mtab05/pls-simulator/README.md

# pls-simulator
Video description of project - https://www.youtube.com/watch?v=LKZQRzaUKww

Project report - https://github.com/mtab05/pls-simulator/blob/main/Final_Report-Haptic_Feedback_Training_for_Pediatric_Laparoscopic_Surgery_Simulators-Group20.pdf
