mtab05/pls-simulator/(commit log)

2021-11-17 Basic sketch to test multiple LRA motors using multiple PWM pins
2021-11-19 IMU sketch commit #1
    This version uses I2C to link the Arduino to 2 IMUs, however data is not
    being transmitted properly to the Serial monitor/plotter.
    Requires further investigation into source code.
2021-11-19 V2 of IMU test code.
    Both IMUs are recording data, but the serial plotter is a bit of a pain
    Considering moving to MATLAB
2021-11-19 Created a live plot script for the IMUs in MATLAB
    Mostly functional but needs some work to decipher units and axes
2021-11-23 Python code for reading serial data from IMUs
    Reads data from serial port, parses and splits arrays for measurements
    Needs some work to plot properly
2022-02-07 Sensors Integration prototyped and tested
    Sensors Integration prototyped and tested
    - 2x LSM9DS1 imu
    - 2x PMW3389 optical sensors
    - Communication protocol: SPI
2022-02-07 2x LSM9DS1 imu & 2x PMW3389 optical sensors via SPI
2022-02-07 Datasheets for sensors
2022-02-16 Uploaded the FSM controller Python script
    This is the 'first draft' of the actuator/ state controller code. It will require some updates to support the serial connection as well as the subroutine/actuator pattern parameters
2022-03-02 optical sensor python interface test
2022-03-13 Tested arduino to python actuator interface
2022-03-22 Delete ActuatorFSM.py
    Deleting this copy as it is present in Python directory
2022-03-22 Rename ActuatorFSM~.py to PLS_Actuator.py
    Renaming code to PLS_Actuator.py to clarify the actuator-pls_sensors interface
2022-03-22 Added "ok" string to FSM of actuators Created string triggered subroutines in the arduino sketch Sensors_Actuator_Interface_test.ino
2022-03-23 Edited subroutines in Sensors_Actuator_Interface_test.ino to add another motor to roll sequence
